k3iyer/arduino-dac/Host_Software/RXTX/Windows/i368-mingw32/README

Wed Mar  1 12:01:05 MST 2006
rxtxSerial.dll had to be recomopiled to link in missing native methods.
