k3iyer/arduino-dac/Device_Hardware/Battery Cycler - Pin assignments.xls

Battery Cycler - Pin Assignments
Arduino Digital I/O | assignment | description
0 | Serial(RX) | connected to ft232r chip
1 | Serial(TX) | connected to ft232r chip
2 | push button up |  | Note: pins 1 & 2 external interrupts
3 | push button select
4 | push button down
5 | LCD D4 / CS ADC1 | lcd data bit 4 and also the chip select for the ADC on ch1 | Note: when using the charge/load mode select we can get away with only one 2 channel DAC if we want
6 | LCD D5 / CS DAC1
7 | LCD D6 / CS DAC2
8 | LCD D7 / CS AUX
9 | LCD RS
10 | LCD enable
11 | SPI (MOSI) | master out slave in
12 | SPI (MISO) | master in slave out
13 | SPI (SCK) | serial clock
Arduino Analog inputs
0 | CH1 cell temp
1 | CH2 cell temp
2 | Chamber air temp
3 | 595 data latch | latch data into the 595 shift register, cannot share like a CS
4 | I2C SDA
5 | I2C SCL
Outputs on 74HC595
B0 / A | TRIAC control output | slow PWM the triac
B1 | Fan control output | enable / disable the load/charge bank cooling fans
B2 | Mode select CH0 | charge / discharge selector for CH0
B3 | Mode select CH1 | charge / discharge selector for CH1
B4
B5 | charge enable
B6 | panel Fault LED
B7 / H | heartbeat for watchdog
