k3iyer/arduino-dac/Documentation/Experimentation/data from level shifting design.xlsx

Batt voltage | meas ref | meas -vbat | meas sum | meas I | calc | measured sum - calc sum | error current | corrected current
2 | 0.05216 | 4.0336 | 4.087 | 2.07 | 4.08576 | 0.00124 | 0.0248 | 2.0948
2.5 | 0.05214 | 3.531 | 3.585 | 2.07 | 3.58314 | 0.00186 | 0.0372 | 2.1072
3 | 0.05214 | 3.029 | 3.083 | 2.08 | 3.08114 | 0.00186 | 0.0372 | 2.1172
3.5 | 0.05212 | 2.533 | 2.585 | 2.128 | 2.58512 | -0.00012 | -0.0024 | 2.1256
4 | 0.05211 | 2.033 | 2.086 | 2.175 | 2.08511 | 0.00089 | 0.0178 | 2.1928
4.2 | 0.05213 | 1.832 | 1.884 | 2.188 | 1.88413 | -0.00013 | -0.0026 | 2.1854
Charge Ref | Charge I |  | Discharge Ref | Discharge I
0.01 | 1.164 |  | 0.01 | 2.008
0.02 | 1.363 |  | 0.02 | 1.898
0.03 | 1.563 |  | 0.03 | 1.701
0.04 | 1.763 |  | 0.04 | 1.508
0.05 | 1.997 |  | 0.05 | 1.314
0.06 | 2.177 |  | 0.06 | 1.117
0.07 | 2.371 |  | 0.07 | 0.977
0.08 | 2.57 |  | 0.08 | 0.976
0.09 | 2.768 |  | 0.09 | 0.977
0.1 | 2.966 |  | 0.1 | 0.976
Discharge Ref | Batt current
0.01 | 2.172
0.02 | 2.343
0.03 | 2.513
0.04 | 2.674
0.05 | 2.837
0.06 | 2.99
0.07 | 3.171
0.08 | 3.326
0.09 | 3.506
0.1 | 3.672
