k3iyer/arduino-dac/Documentation/Official/archive/battery cycler menus.docx

MENU SYSTEM:

There are currently 5 different configuration menus.

E | X | I | T
| | | | | | | | | | | | | | → | →
+ | + | | | | | | | | | | | | | + | +

D | I | S | P | | T | I | M | E | | O | U | T

D | I | S | P | | D | E | L | A | Y | | T | I | M | E

F | A | N | | O | N | | T | E | M | P

S | W | | V | E | R | S | I | O | N

STATS DISPLAY:

Currently there are 8 status displays; they are shown here in they same order as on the system.

C | H | 1 | : | | A | C | T | I | V | E | | # | 2 | 5 | 6
| | | | | I | D | L | E
| | | | | F | A | U | L | T | | | # | 2 | 5 | 6
C | H | 2 | : | | A | C | T | I | V | E | | # | 2 | 5 | 6

C | H | 1/2 | : | | | | V | = | | | 6 | . | 0 | 0 | 0
W | = | +/- | 1 | 5 | 0 | | I | = | +/- | 2 | 0 | . | 0 | 0 | 0

C | H | ½ | : | | | | S | O | C | = | 1 | 0 | 0 | . | 5
| C | E | L | L | | T | E | M | P | = | 1 | 5 | 0 | ° | C

C | H | ½ | : | | | L | O | A | D | = | 1 | 5 | 0 | ° | C
| | | | C | H | A | R | G | E | = | 1 | 5 | 0 | ° | C

C | H | M | B | R | | | S | E | T | = | 1 | 5 | 0 | ° | C
| | | | | | M | E | A | S | = | 1 | 5 | 0 | ° | C
