k3iyer/arduino-dac/Documentation/Official/Graphics/1940 -  Speed Cycler Sticker.gif

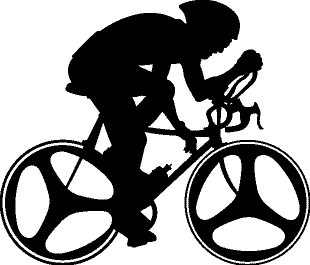
Documentation/Official/Graphics/1940 - Speed Cycler Sticker.gif
