k3iyer/arduino-dac/Documentation/Official/Graphics/LI-18650-T.400.jpg

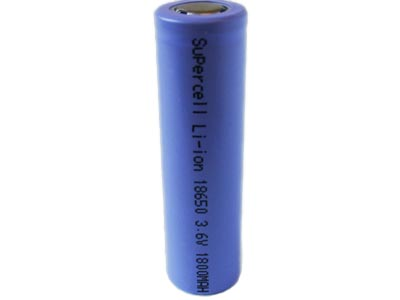
Documentation/Official/Graphics/LI-18650-T.400.jpg
