k3iyer/arduino-dac/Documentation/Official/Graphics/re-cycler.GIF

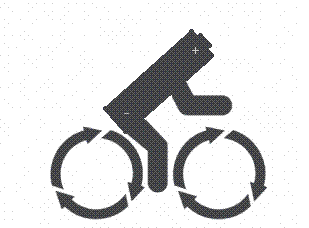
Documentation/Official/Graphics/re-cycler.GIF
