k3iyer/arduino-dac/Documentation/Official/Graphics/re-cycler.png

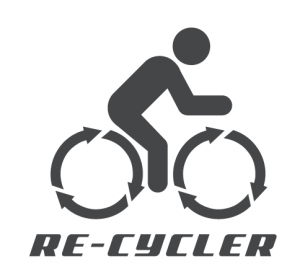
Documentation/Official/Graphics/re-cycler.png
