k3iyer/arduino-dac/Device_Hardware/bom/BOM battery tester - Initial order.xlsx

BOM For: | 2-channel Tybin board for lifecycle testing
Date: | 2010-06-25
Number of units: | 14
Item # | Description | Part Number | Retailer | Unit Cost $ | Order QTY | Extended Cost $
6 | dual DAC | MCP4822-E/SN-ND (http://search.digikey.com/scripts/DkSearch/dksus.dll?Detail&name=MCP4822-E/SN-ND) | Digikey | $3.60 | 28 | $100.80
7 | 5mOhm current shunt for data acq | 13FR005E-ND (http://search.digikey.com/scripts/DkSearch/dksus.dll?Detail&name=13FR005E-ND) | Digikey | $1.72 | 28 | $48.16
8 | IC Current Monitor, bidirectional (replaces diff amp) | AD8210WYRZ-ND (http://search.digikey.com/scripts/DkSearch/dksus.dll?Detail&name=AD8210WYRZ-ND) | Digikey | $2.78 | 140 | $389.20
12 | 12A n-channel mosfets | RFP12N10L | Digikey | $0.62 | 224 | $138.88
13 | 50mOhm current shunts for feedback | 630HR050E-ND | Digikey | $0.45 | 224 | $99.68
18 | Temp Sensor, Chamber control, Cell monitoring | LM35DZ-ND (http://search.digikey.com/scripts/DkSearch/dksus.dll?Detail&name=LM35DZ-ND) | Digikey | $1.37 | 56 | $76.72
25 | KPS55 5V 3W supply TDK-Lambda | 285-1421-ND | Digikey | $17.00 | 14 | $238.00
26 | Power supply TDK-Lambda 5V 20A SNG OUTPUT | 285-1611-ND | Digikey | $54.00 | 14 | $756.00
54 | 8A SSR | 425-2405-5-ND | Digikey | $9.40 | 14 | $131.60
55 | Varistor 140Vrms 10mm radial | 495-1429-ND | Digikey | $0.51 | 14 | $7.14
29 | Heatsinks 41.91 x 25.40 x 50.8mm for load bank | 345-1035-ND | Digikey | $1.54 | 224 | $344.96
36 | Pomona 72' Red test lead | 501-1052-ND | Digikey | $4.56 | 28 | $127.68
37 | Pomona 72' Black test lead | 501-1049-ND (http://search.digikey.com/scripts/DkSearch/dksus.dll?Detail&name=501-1049-ND) | Digikey | $4.56 | 28 | $127.68
39 | 500' spool of 3conductor 22AWG for temp sensors ($89.43 / 12)=7.45 | W121-500-ND (http://search.digikey.com/scripts/DkSearch/dksus.dll?Detail&name=W121-500-ND) | Digikey | $89.43 | 1 | $89.43
40 | 4pos 0.1" pitch female socket for connecting lm35 sensors | A28582-ND | Digikey | $0.63 | 56 | $35.28
41 | 4pos 0.1" pitch male plug for connecting lm35 sensors | A34192-ND | Digikey | $0.51 | 56 | $28.45
57 | 6A IEC 320-C14 line entry with dpst switch and fuse holder | Q306-ND (http://search.digikey.com/scripts/DkSearch/dksus.dll?Detail&name=Q306-ND) | Digikey | $6.20 | 1 | $6.20
58 | nema 5-15 receptacle for output to heater | Q337-ND | Digikey | $0.50 | 1 | $0.50
59 | IEC 320-C13 6' line cord | Q102-ND (http://search.digikey.com/scripts/DkSearch/dksus.dll?Detail&name=Q102-ND) | Digikey | $3.00 | 1 | $3.00
 | IEC 320-C14 3.25' cord (chamber air cictulator) | Q128-ND (http://search.digikey.com/scripts/DkSearch/dksus.dll?Detail&name=Q128-ND) | Digikey | $3.25 | 1 | $3.25
 | IEC 320-C13 outlet (chamber air circulator) | Q223-ND (http://search.digikey.com/scripts/DkSearch/dksus.dll?Detail&name=Q223-ND) | Digikey | $0.91 | 1 | $0.91
 | 12AWG Black test lead 100' | 602-6718-100-02 | Mouser | $165.00 | 1 | $165.00
 | 12AWG Red test lead 100' | 602-6718-100-03 | Mouser | $165.00 | 1 | $165.00
 | 120mm air circulation fan, thermal chamber | 670-OA109AP113TB (http://mouser.com/ProductDetail/Orion-Fans/OA109AP-11-3TB/) | Mouser | $14.79 | 1 | $14.79
20 | 60mm cooling fan | OD6025-05HB | Mouser | $9.18 | 2 | $18.36
46 | 3pos molex KK PCB header for fan connection | 09-65-2038 | Mouser | $0.52 | 2 | $1.04
47 | 3pos molex KK crimp connector for fan connection | 09-50-1031 | Mouser | $0.55 | 2 | $1.10
2 | Hantronix 16x2 STN LCD | HDM16216L-5-E30S | Mouser | $8.49 | 14 | $118.86
5 | 14BIT 4 channel, 200KSPS ADC | 595-TLC3544IDW | Mouser | $11.73 | 14 | $164.22
35 | dual banana binding posts red/blk | 565-6883 | Mouser | $2.80 | 56 | $156.80
1 | Arduino Duemilanove | DEV-00666 | Sparkfun | $29.95 | 14 | $419.30
30 | Bud Industries PRM-14462 Rack mount enclosure | PRM-14462 | Newark | $35.00 | 1 | $35.00
 |  |  |  |  | Total: | $4012.99
