k3iyer/arduino-dac/Device_Hardware/bom/BOM DLC board for ted.xlsx

Sheet: Sheet1
BOM For: | 2-channel DLC (data acq, load, charge) board for lifecycle testing
Date: | 2010-06-24
 | Areas where cost could possibly be reduced
 |  |  |  |  |  |  |  | Number systems being built = | 12
Item # | Description | Part Number | Reatiler | Order? | QTY | Unit Cost $ | Extended Cost $ |  | ORDER QTY | ORDER COST $
 | Electronics
1 | Arduino Duemilanove | DEV-00666 | Sparkfun | 1 | 1 | 29.95 | 29.95 |  | 12 | 359.4
2 | Hantronix 16x2 STN LCD | HDM16216H-5-S00S | Mouser | 1 | 1 | 7.43 | 7.43 |  | 12 | 89.16
3
4 | Insturmentation Amplifiers for data acq voltage | AD8221ARZ-ND | Digikey | 1 | 2 | 5.42 | 10.84 | Note: Can we get rid of these for cell voltages too? Voltage droop over trace? | 24 | 130.08
5 | 14BIT 4 channel, 200KSPS ADC | TLC3544 | Newark | 1 | 1 | 11.73 | 11.73 |  | 12 | 140.76
6 | dual DAC | MCP4822-E/P-ND | Digikey | 1 | 2 | 3.6 | 7.2 |  | 24 | 86.4
7 | 5mOhm current shunt | 13FR005E-ND (http://search.digikey.com/scripts/DkSearch/dksus.dll?Detail&name=13FR005E-ND) | Digikey | 1 | 1 | 1.72 | 1.72
8 | IC Current Monitor, bidirectional (replaces diff amp) | AD8210WYRZ-ND (http://search.digikey.com/scripts/DkSearch/dksus.dll?Detail&name=AD8210WYRZ-ND) | Digikey | 1 | 2 | 4.07 | 8.14
9 | Temp Sensor TO-220 | TC622VAT-ND | Digikey | 1 | 4 | 1.46 | 5.84 |  | 48 | 70.08
10
11
12 | 12A n-channel mosfets | RFP12N10L | Digikey | 1 | 16 | 0.89 | 14.24 |  | 192 | 170.88
13 | 50mOhm current shunts | 630HR050E-ND | Digikey | 1 | 16 | 0.445 | 7.12 |  | 192 | 85.44
14 | low noise quad opamp | MC33079PGOS-ND | Digikey | 1 | 8 | 1.44 | 11.52 |  | 96 | 138.24
15 | 10K ohm resistor packs 8ea | NOMCT16-10K-ACT-ND | Digikey |  | 8 | 5.6 | 0 |  | 96 | 0
16
17
18 | Temp Sensor, Chamber control, Cell monitoring | LM35DZ-ND (http://search.digikey.com/scripts/DkSearch/dksus.dll?Detail&name=LM35DZ-ND) | Digikey | 1 | 4 | 1.37 | 5.48 |  | 48 | 65.76
19 | Small logic level gate for switching opamps and fans | 568-3244-1-ND | Digikey | 1 | 6 | 0.54 | 3.24 |  | 72 | 38.88
20 | 60mm cooling fan | OD6025-12HS-C | Mouser | 1 | 2 | 4.95 | 9.9 |  | 24 | 118.8
21 |  |  |  |  |  |  | 0 |  | 0 | 0
22 | PCB - PCBexpress E2 (45-64^2in boards) ($680 for 15 / 12) |  | PCBExpress |  | 1 | 56.6 | 0 |  | 12 | 0
23
24 | charge pump voltage inverter for opamp nexative supply | TC962COE-ND (http://search.digikey.com/scripts/DkSearch/dksus.dll?Detail&name=TC962COE-ND) | Digikey | 1 | 1 | 3.48 | 3.48 |  | 12 | 41.76
25 | Wall xfmr 12Vdc 500ma | T983-P5P-ND | Digikey | 1 | 1 | 6.98 | 6.98 |  | 12 | 83.76
26 | Power supply TDK-Lambda 5V 20A SNG OUTPUT | 285-1611-ND | Digikey | 1 | 1 | 54 | 54 |  | 12 | 648
27 | Mechanical |  |  |  |  |  | 0 |  | 0 | 0
28 | Heatsinks 16.25 x 16.25 x 50.8mm for charger | 345-1027-ND | Digikey | 0 | 0 | 2.25 | 0 |  | 0 | 0
29 | Heatsinks 41.91 x 25.40 x 50.8mm for load bank | 345-1035-ND | Digikey | 1 | 16 | 2.2 | 35.2 |  | 192 | 422.4
30 | Bud Industries PRM-14462 Rack mount enclosure | PRM-14462 | Newark | 1 | 1 | 35 | 35 |  | 12 | 420
31
32 |  |  |  |  |  |  | 0 |  | 0 | 0
33 |  |  |  |  |  |  | 0 |  | 0 | 0
34 | misc wiring and connectors |  |  |  | 1 | 10 | 0 |  | 12 | 0
35 | dual banana binding posts red/blk | 565-6883 | Mouser | 1 | 4 | 2.8 | 11.2 |  | 48 | 134.4
36 | Pomona 72' Red test lead | 501-1052-ND | Digikey | 1 | 4 | 4.56 | 18.24 |  | 48 | 218.88
37 | Pomona 72' Black test lead | 501-1049-ND (http://search.digikey.com/scripts/DkSearch/dksus.dll?Detail&name=501-1049-ND) | Digikey | 1 | 4 | 4.56 | 18.24 |  | 48 | 218.88
38 |  |  |  |  |  |  | 0 |  | 0 | 0
39 | 500' spool of 3conductor 22AWG for temp sensors ($89.43 / 12)=7.45 | W121-500-ND (http://search.digikey.com/scripts/DkSearch/dksus.dll?Detail&name=W121-500-ND) | Digikey | 1 | 1 | 7.45 | 7.45 | Note: can cut cost in half by using ribbon cable (MB10R-100-ND) | 12 | 89.4
40 | 4pos 0.1" pitch female socket for connecting lm35 sensors | A28582-ND | Digikey | 1 | 4 | 0.63 | 2.52 |  | 48 | 30.24
41 | 4pos 0.1" pitch male plug for connecting lm35 sensors | A34192-ND | Digikey | 1 | 4 | 0.508 | 2.032 |  | 48 | 24.384
42 |  |  |  |  |  |  | 0 |  | 0 | 0
43 | 2 pos High Current connector socket for PSW and Panel connections | 42819-2222 | Mouser | 1 | 3 | 1.94 | 5.82 |  | 36 | 69.84
44 | 2 pos High Current connector plug for PSW and Panel connections | 42816-0212 | Mouser | 1 | 3 | 1.15 | 3.45 |  | 36 | 41.4
45 |  |  |  |  |  |  | 0 |  | 0 | 0
46 | 3pos molex KK PCB header for fan connection | 09-65-2038 | Mouser | 1 | 2 | 0.52 | 1.04 |  | 24 | 12.48
47 | 3pos molex KK crimp connector for fan connection | 09-50-1031 | Mouser | 1 | 2 | 0.55 | 1.1 |  | 24 | 13.2
48 |  |  |  |  |  |  | 0 |  | 0 | 0
49
50 |  |  |  |  |  |  | 0 |  | 0 | 0
51 |  |  |  |  |  |  | 0 |  | 0 | 0
52 | Thermal Chamber |  |  |  |  |  | 0 |  | 0 | 0
53 | 4' x 8' sheet of 0.5" Super TUFF-R insulation |  | Home Depot |  | 1 | 11 | 0 |  | 12 | 0
54 | 8A SSR | 425-2405-5-ND | Digikey | 1 | 1 | 9.4 | 9.4 |  | 12 | 112.8
55 | Varistor 140Vrms 10mm radial | 495-1429-ND | Digikey | 1 | 1 | 0.51 | 0.51 |  | 12 | 6.12
56 | SCR200W Crockpot | SCR200W | Walmart |  | 1 | 10 | 0 |  | 12 | 0
57 | 10A line entry with dpst switch and fuse | Q308-ND | Digikey | 1 | 1 | 8.23 | 8.23 |  | 12 | 98.76
58 | nema 5-15 receptacle for output to heater | Q337-ND | Digikey | 1 | 1 | 0.5 | 0.5 |  | 12 | 6
59 |  |  |  |  |  |  | 0 |  | 0 | 0
60 |  |  |  |  |  |  | 0 |  | 0 | 0
61 |  |  |  |  |  |  | 0 |  | 0 | 0
62 |  |  |  |  |  |  | 0 |  | 0 | 0
63 |  |  |  |  |  |  | 0 |  | 0 | 0
64 |  |  |  |  |  |  | 0 |  | 0 | 0
65 |  |  |  |  |  |  | 0 |  | 0 | 0
66 |  |  |  |  |  |  | 0 |  | 0 | 0
67 |  |  |  |  |  |  | 0 |  | 0 | 0
68 |  |  |  |  |  |  | 0 |  | 0 | 0
69 |  |  |  |  |  |  | 0 |  | 0 | 0
70 |  |  |  |  |  |  | 0 |  | 0 | 0
 |  |  |  |  |  | Total Price $ | 358.742 |  | ORDER TOTAL$ | 4186.584
 |  |  |  |  |  | Cost per channel | 179.371

Sheet: Sheet2
BOM For: | 2-channel DLC (data acq, load, charge) board for lifecycle testing
Date: | 2010-06-25
Item # | Description | Part Number | Reatiler | Unit Cost $ | Order QTY | Extended Cost $
6 | dual DAC | MCP4822-E/SN-ND (http://search.digikey.com/scripts/DkSearch/dksus.dll?Detail&name=MCP4822-E/SN-ND) | Digikey | $3.60 | 28 | $100.80
7 | 5mOhm current shunt for data acq | 13FR005E-ND (http://search.digikey.com/scripts/DkSearch/dksus.dll?Detail&name=13FR005E-ND) | Digikey | $1.72
8 | IC Current Monitor, bidirectional (replaces diff amp) | AD8210WYRZ-ND (http://search.digikey.com/scripts/DkSearch/dksus.dll?Detail&name=AD8210WYRZ-ND) | Digikey | $4.07
12 | 12A n-channel mosfets | RFP12N10L | Digikey | $0.89 | 224 | $199.36
13 | 50mOhm current shunts for feedback | 630HR050E-ND | Digikey | $0.45 | 224 | $99.68
18 | Temp Sensor, Chamber control, Cell monitoring | LM35DZ-ND (http://search.digikey.com/scripts/DkSearch/dksus.dll?Detail&name=LM35DZ-ND) | Digikey | $1.37 | 56 | $76.72
25 | KPS55 5V 3W supply TDK-Lambda | 285-1421-ND | Digikey | $17.00 | 14 | $238.00
26 | Power supply TDK-Lambda 5V 20A SNG OUTPUT | 285-1611-ND | Digikey | $54.00 | 14 | $756.00
54 | 8A SSR | 425-2405-5-ND | Digikey | $9.40 | 14 | $131.60
55 | Varistor 140Vrms 10mm radial | 495-1429-ND | Digikey | $0.51 | 14 | $7.14
29 | Heatsinks 41.91 x 25.40 x 50.8mm for load bank | 345-1035-ND | Digikey | $2.20 | 224 | $492.80
36 | Pomona 72' Red test lead | 501-1052-ND | Digikey | $4.56 | 56 | $255.36
37 | Pomona 72' Black test lead | 501-1049-ND (http://search.digikey.com/scripts/DkSearch/dksus.dll?Detail&name=501-1049-ND) | Digikey | $4.56 | 56 | $255.36
39 | 500' spool of 3conductor 22AWG for temp sensors ($89.43 / 12)=7.45 | W121-500-ND (http://search.digikey.com/scripts/DkSearch/dksus.dll?Detail&name=W121-500-ND) | Digikey | $7.45 | 14 | $104.30
40 | 4pos 0.1" pitch female socket for connecting lm35 sensors | A28582-ND | Digikey | $0.63 | 56 | $35.28
41 | 4pos 0.1" pitch male plug for connecting lm35 sensors | A34192-ND | Digikey | $0.51 | 56 | $28.45
20 | 60mm cooling fan | OD6025-05HB | Mouser | $9.18 | 2 | $18.36
46 | 3pos molex KK PCB header for fan connection | 09-65-2038 | Mouser | $0.52 | 2 | $1.04
47 | 3pos molex KK crimp connector for fan connection | 09-50-1031 | Mouser | $0.55 | 2 | $1.10
2 | Hantronix 16x2 STN LCD | HDM16216H-5-S00S | Mouser | $7.43 | 14 | $104.02
5 | 14BIT 4 channel, 200KSPS ADC | 595-TLC3544IDW | Mouser | $11.73 | 14 | $164.22
35 | dual banana binding posts red/blk | 565-6883 | Mouser | $2.80 | 56 | $156.80
1 | Arduino Duemilanove | DEV-00666 | Sparkfun | $29.95 | 14 | $419.30
30 | Bud Industries PRM-14462 Rack mount enclosure | PRM-14462 | Newark | $35.00 | 1 | $35.00
 |  |  |  |  | Total: | $3680.69
