k3iyer/arduino-dac/Device_Hardware/bom/BOM DLC board proto.xlsx

BOM For: | Proto Sample parts for - 2-channel DLC (data acq, load, charge) board for lifecycle testing
Date: | 2010-06-15
Item # | Description | Part Number | QTY | Unit Price $ | Extended Price $
1 | Small logic level gate for switching opamps (may not need if we get opamps that work close enough to there rails, can just switch with the IO pin of the micro!) | 568-3244-1-ND | 5 | 0.54 | 2.7
2 | Insturmentation Amplifiers for data acq voltage | AD8221ARZ-ND (http://search.digikey.com/scripts/DkSearch/dksus.dll?Detail&name=AD8221ARZ-ND) | 1 | 5.42 | 5.42
3 | LV charge pump voltage doubler | TC7660SEPA-ND (http://search.digikey.com/scripts/DkSearch/dksus.dll?Detail&name=TC7660SEPA-ND) | 2 | 1.6 | 3.2
4 | HV microchip charge pump DIP | TC7662ACPA-ND (http://search.digikey.com/scripts/DkSearch/dksus.dll?Detail&name=TC7662ACPA-ND) | 1 | 3.17 | 3.17
5 | Temp sensor | LM35DZ-ND (http://search.digikey.com/scripts/DkSearch/dksus.dll?Detail&name=LM35DZ-ND) | 2 | 1.71 | 3.42
6 | dual DAC | MCP4822-E/P-ND (http://search.digikey.com/scripts/DkSearch/dksus.dll?Detail&name=MCP4822-E/P-ND) | 1 | 3.6 | 3.6
7 | quad opamps for controlling mosfets(low input offset, Rail-Rail) | 296-7129-5-ND (http://search.digikey.com/scripts/DkSearch/dksus.dll?Detail&name=296-7129-5-ND) | 2 | 2.2 | 4.4
8 | low noise quad opamp | MC33079PGOS-ND (http://search.digikey.com/scripts/DkSearch/dksus.dll?Detail&name=MC33079PGOS-ND) | 4 | 1.44 | 5.76
9 | 5W 0.001 ohm current shunt | LVRC-.01RCT-ND (http://search.digikey.com/scripts/DkSearch/dksus.dll?Detail&name=LVRC-.01RCT-ND) | 1 | 1.61 | 1.61
10 | 20W 0.03 ohm current shunt | TK20PR030JE-ND (http://search.digikey.com/scripts/DkSearch/dksus.dll?Detail&name=TK20PR030JE-ND) | 1 | 4.87 | 4.87
11 |  |  |  |  | 0
12 |  |  |  |  | 0
13 |  |  |  |  | 0
14 |  |  |  |  | 0
15 |  |  |  |  | 0
16 |  |  |  |  | 0
17 |  |  |  |  | 0
18 |  |  |  |  | 0
19 |  |  |  |  | 0
20 |  |  |  |  | 0
21 |  |  |  |  | 0
22 |  |  |  |  | 0
23 |  |  |  |  | 0
24 |  |  |  |  | 0
25 |  |  |  |  | 0
26 |  |  |  |  | 0
27 |  |  |  |  | 0
28 |  |  |  |  | 0
29 |  |  |  |  | 0
30 |  |  |  |  | 0
 |  |  |  | Total Price $ | 38.15
