k3iyer/arduino-dac/Device_Hardware/bom/BOM DLC board.xlsx

Sheet: BOM
BOM For: | 2-channel DLC (data acq, load, charge) board for lifecycle testing
Date: | 2010-06-24
 | Areas where cost could possibly be reduced |  |  |  |  |  |  |  | Build units:
 |  |  |  |  |  |  |  |  | 14
Item # | Description | Part Number | Reatiler | ORDER NOW | QTY | Unit Cost $ | Extended Cost $ | Subsystem cost $ | ORDER QTY | ORDER COST $
 | Electronics |  |  |  |  |  |  | $299.14
6 | 12-Bit SPI DAC dual | MCP4822-E/SN-ND (http://search.digikey.com/scripts/DkSearch/dksus.dll?Detail&name=MCP4822-E/SN-ND) | Digikey | Y | 2 | 3.6 | 7.2 |  | 28 | 100.8
7 | 5mOhm current shunt for data acq | 13FR005E-ND (http://search.digikey.com/scripts/DkSearch/dksus.dll?Detail&name=13FR005E-ND) | Digikey | Y | 1 | 1.72 | 1.72
3 |  |  |  |  |  |  | $0.00
4 | Insturmentation Amplifiers for data acq voltage | AD8221ARZ-ND | Digikey |  | 2 | $5.42 | $10.84 |  | 28 | $151.76
 | Vrefs 4.096 | REF198FSZ-ND (http://search.digikey.com/scripts/DkSearch/dksus.dll?Detail&name=REF198FSZ-ND) | Digikey
 | 2.048
8 | IC Current Monitor, bidirectional (replaces diff amp) | AD8210WYRZ-ND (http://search.digikey.com/scripts/DkSearch/dksus.dll?Detail&name=AD8210WYRZ-ND) | Digikey | Y | 10 | 2.78 | 27.8
12 | 12A n-channel mosfets | RFP12N10L | Digikey | Y | 16 | 0.89 | 14.24 |  | 224 | 199.36
13 | 50mOhm current shunts for feedback | 630HR050E-ND | Digikey | Y | 16 | 0.445 | 7.12 |  | 224 | 99.68
18 | Temp Sensor, Chamber control, Cell monitoring | LM35DZ-ND (http://search.digikey.com/scripts/DkSearch/dksus.dll?Detail&name=LM35DZ-ND) | Digikey | Y | 4 | 1.37 | 5.48 |  | 56 | 76.72
9 | Temp Sensor TO-220 | TC622VAT-ND | Digikey |  | 4 | $1.46 | $5.84 |  | 56 | $81.76
10 |  |  |  |  |  |  | $0.00
11 |  |  |  |  |  |  | $0.00
25 | KPS55 5V 3W supply TDK-Lambda | 285-1421-ND | Digikey | Y | 1 | 17 | 17 |  | 14 | 238
26 | Power supply TDK-Lambda 5V 20A SNG OUTPUT | 285-1611-ND | Digikey | Y | 1 | 54 | 54 |  | 14 | 756
14 | low noise quad opamp | MC33079PGOS-ND | Digikey |  | 8 | $1.44 | $11.52 |  | 112 | $161.28
15 | 10K ohm resistor packs 8ea | NOMCT16-10K-ACT-ND | Digikey |  | 4 | $5.60 | $22.40 |  | 56 | $313.60
16 |  |  |  |  |  |  | $0.00
17 |  |  |  |  |  |  | $0.00
54 | 8A SSR | 425-2405-5-ND | Digikey | Y | 1 | 9.4 | 9.4 |  | 14 | 131.6
19 | Small logic level gate for switching opamps and fans | 568-3244-1-ND | Digikey |  | 6 | $0.54 | $3.24 |  | 84 | $45.36
20 | 60mm cooling fan | OD6025-05HB | Mouser |  | 2 | $9.18 | $18.36 |  | 28 | $257.04
21 |  |  |  |  |  |  | $0.00 |  | 0 | $0.00
22 | PCB - PCBexpress E2 (45-64^2in boards) ($680 for 15 / 12) |  | PCBExpress |  | 1 | $56.60 | $56.60 |  | 14 | $792.40
23 |  |  |  |  |  |  | $0.00
24 | charge pump voltage inverter for opamp nexative supply | TC1121COA-ND (http://search.digikey.com/scripts/DkSearch/dksus.dll?Detail&name=TC1121COA-ND) | Digikey |  | 1 | $1.23 | $1.23 |  | 14 | $17.22
55 | Varistor 140Vrms 10mm radial | 495-1429-ND | Digikey | Y | 1 | 0.51 | 0.51 |  | 14 | 7.14
29 | Heatsinks 41.91 x 25.40 x 50.8mm for load bank | 345-1035-ND | Digikey | Y | 16 | 1.54 | 24.64 |  | 224 | 344.96
57 | 6A IEC 320-C14 line entry with dpst switch and fuse holder | Q306-ND (http://search.digikey.com/scripts/DkSearch/dksus.dll?Detail&name=Q306-ND) | Digikey |  | 1 | $6.20 | $6.20 |  | 14 | $86.80
58 | nema 5-15 receptacle for output to heater | Q337-ND | Digikey |  | 1 | $0.50 | $0.50 |  | 14 | $7.00
59 | IEC 320-C13 6' line cord | Q102-ND (http://search.digikey.com/scripts/DkSearch/dksus.dll?Detail&name=Q102-ND) | Digikey |  | 1 | $3.00 | $3.00 |  | 14 | $42.00
36 | Pomona 72' Red test lead | 501-1052-ND | Digikey | Y | 4 | 4.56 | 18.24 |  | 56 | 255.36
37 | Pomona 72' Black test lead | 501-1049-ND (http://search.digikey.com/scripts/DkSearch/dksus.dll?Detail&name=501-1049-ND) | Digikey | Y | 4 | 4.56 | 18.24 |  | 56 | 255.36
27 | Mechanical |  |  |  |  |  | $0.00 | $42.45 | 0 | $0.00
28 | Heatsinks 16.25 x 16.25 x 50.8mm for charger | 345-1027-ND | Digikey |  | 0 | $2.25 | $0.00 |  | 0 | $0.00
39 | 500' spool of 3conductor 22AWG for temp sensors ($89.43 / 12)=7.45 | W121-500-ND (http://search.digikey.com/scripts/DkSearch/dksus.dll?Detail&name=W121-500-ND) | Digikey | Y | 1 | 7.45 | 7.45 |  | 14 | 104.3
30 | Bud Industries PRM-14462 Rack mount enclosure | PRM-14462 | Newark |  | 1 | $35.00 | $35.00 |  | 14 | $490.00
31 |  |  |  |  |  |  | $0.00
32 |  |  |  |  |  |  | $0.00 |  | 0 | $0.00
33 |  |  |  |  |  |  | $0.00 |  | 0 | $0.00
34 | misc wiring and connectors |  |  |  | 1 | $10.00 | $10.00 | $76.27 | 14 | $140.00
40 | 4pos 0.1" pitch female socket for connecting lm35 sensors | A28582-ND | Digikey | Y | 4 | 0.63 | 2.52 |  | 56 | 35.28
41 | 4pos 0.1" pitch male plug for connecting lm35 sensors | A34192-ND | Digikey | Y | 4 | 0.508 | 2.032 |  | 56 | 28.448
2 | Hantronix 16x2 STN LCD | HDM16216H-5-S00S | Mouser | Y | 1 | 7.43 | 7.43 |  | 14 | 104.02
38 |  |  |  |  |  |  | $0.00 |  | 0 | $0.00
5 | 14BIT 4 channel, 200KSPS ADC | HDM16216L-5-E30S | Mouser | Y | 1 | 11.73 | 11.73 |  | 14 | 164.22
35 | dual banana binding posts red/blk | 565-6883 | Mouser | Y | 4 | 2.8 | 11.2 |  | 56 | 156.8
1 | Arduino Duemilanove | DEV-00666 | Sparkfun | Y | 1 | 29.95 | 29.95 |  | 14 | 419.3
42 |  |  |  |  |  |  | $0.00 |  | 0 | $0.00
43 | 2 pos High Current connector socket for PSW and Panel connections | 42819-2222 | Mouser |  | 3 | $1.94 | $5.82 |  | 42 | $81.48
44 | 2 pos High Current connector plug for PSW and Panel connections | 42816-0212 | Mouser |  | 3 | $1.15 | $3.45 |  | 42 | $48.30
45 |  |  |  |  |  |  | $0.00 |  | 0 | $0.00
46 | 3pos molex KK PCB header for fan connection | 09-65-2038 | Mouser |  | 2 | $0.52 | $1.04 |  | 28 | $14.56
47 | 3pos molex KK crimp connector for fan connection | 09-50-1031 | Mouser |  | 2 | $0.55 | $1.10 |  | 28 | $15.40
48 |  |  |  |  |  |  | $0.00 |  | 0 | $0.00
49 |  |  |  |  |  |  | $0.00
50 |  |  |  |  |  |  | $0.00 |  | 0 | $0.00
51 |  |  |  |  |  |  | $0.00 |  | 0 | $0.00
52 | Thermal Chamber |  |  |  |  |  | $0.00 | $21.00 | 0 | $0.00
53 | 4' x 8' sheet of 0.5" Super TUFF-R insulation |  | Home Depot |  | 1 | $11.00 | $11.00 |  | 14 | $154.00
56 | SCR200W Crockpot | SCR200W | Walmart |  | 1 | $10.00 | $10.00 |  | 14 | $140.00
60 |  |  |  |  |  |  | $0.00 |  | 0 | $0.00
61 |  |  |  |  |  |  | $0.00 |  | 0 | $0.00
62 |  |  |  |  |  |  | $0.00 |  | 0 | $0.00
63 |  |  |  |  |  |  | $0.00 |  | 0 | $0.00
64 |  |  |  |  |  |  | $0.00 |  | 0 | $0.00
65 |  |  |  |  |  |  | $0.00 |  | 0 | $0.00
66 |  |  |  |  |  |  | $0.00 |  | 0 | $0.00
67 |  |  |  |  |  |  | $0.00 |  | 0 | $0.00
68 |  |  |  |  |  |  | $0.00 |  | 0 | $0.00
69 |  |  |  |  |  |  | $0.00 |  | 0 | $0.00
70 |  |  |  |  |  |  | $0.00 |  | 0 | $0.00
 |  |  |  |  |  | Total Price $ | 495.042 |  | ORDER TOTAL$ | 6517.308
 |  |  |  |  |  | Cost per channel | 247.521

Sheet: Ted Inital Order
BOM For: | 2-channel DLC (data acq, load, charge) board for lifecycle testing
Date: | 2010-06-25
Number of units: | 14
Item # | Description | Part Number | Retailer | Unit Cost $ | Order QTY | Extended Cost $
6 | dual DAC | MCP4822-E/SN-ND (http://search.digikey.com/scripts/DkSearch/dksus.dll?Detail&name=MCP4822-E/SN-ND) | Digikey | $3.60 | 28 | $100.80
7 | 5mOhm current shunt for data acq | 13FR005E-ND (http://search.digikey.com/scripts/DkSearch/dksus.dll?Detail&name=13FR005E-ND) | Digikey | $1.72 | 28 | $48.16
8 | IC Current Monitor, bidirectional (replaces diff amp) | AD8210WYRZ-ND (http://search.digikey.com/scripts/DkSearch/dksus.dll?Detail&name=AD8210WYRZ-ND) | Digikey | $2.78 | 140 | $389.20
12 | 12A n-channel mosfets | RFP12N10L | Digikey | $0.62 | 224 | $138.88
13 | 50mOhm current shunts for feedback | 630HR050E-ND | Digikey | $0.45 | 224 | $99.68
18 | Temp Sensor, Chamber control, Cell monitoring | LM35DZ-ND (http://search.digikey.com/scripts/DkSearch/dksus.dll?Detail&name=LM35DZ-ND) | Digikey | $1.37 | 56 | $76.72
25 | KPS55 5V 3W supply TDK-Lambda | 285-1421-ND | Digikey | $17.00 | 14 | $238.00
26 | Power supply TDK-Lambda 5V 20A SNG OUTPUT | 285-1611-ND | Digikey | $54.00 | 14 | $756.00
54 | 8A SSR | 425-2405-5-ND | Digikey | $9.40 | 14 | $131.60
55 | Varistor 140Vrms 10mm radial | 495-1429-ND | Digikey | $0.51 | 14 | $7.14
29 | Heatsinks 41.91 x 25.40 x 50.8mm for load bank | 345-1035-ND | Digikey | $1.54 | 224 | $344.96
36 | Pomona 72' Red test lead | 501-1052-ND | Digikey | $4.56 | 28 | $127.68
37 | Pomona 72' Black test lead | 501-1049-ND (http://search.digikey.com/scripts/DkSearch/dksus.dll?Detail&name=501-1049-ND) | Digikey | $4.56 | 28 | $127.68
39 | 500' spool of 3conductor 22AWG for temp sensors ($89.43 / 12)=7.45 | W121-500-ND (http://search.digikey.com/scripts/DkSearch/dksus.dll?Detail&name=W121-500-ND) | Digikey | $89.43 | 1 | $89.43
40 | 4pos 0.1" pitch female socket for connecting lm35 sensors | A28582-ND | Digikey | $0.63 | 56 | $35.28
41 | 4pos 0.1" pitch male plug for connecting lm35 sensors | A34192-ND | Digikey | $0.51 | 56 | $28.45
57 | 6A IEC 320-C14 line entry with dpst switch and fuse holder | Q306-ND (http://search.digikey.com/scripts/DkSearch/dksus.dll?Detail&name=Q306-ND) | Digikey | $6.20 | 1 | $6.20
58 | nema 5-15 receptacle for output to heater | Q337-ND | Digikey | $0.50 | 1 | $0.50
59 | IEC 320-C13 6' line cord | Q102-ND (http://search.digikey.com/scripts/DkSearch/dksus.dll?Detail&name=Q102-ND) | Digikey | $3.00 | 1 | $3.00
 | IEC 320-C14 3.25' cord (chamber air cictulator) | Q128-ND (http://search.digikey.com/scripts/DkSearch/dksus.dll?Detail&name=Q128-ND) | Digikey | $3.25 | 1 | $3.25
 | IEC 320-C13 outlet (chamber air circulator) | Q223-ND (http://search.digikey.com/scripts/DkSearch/dksus.dll?Detail&name=Q223-ND) | Digikey | $0.91 | 1 | $0.91
 | 12AWG Black test lead 100' | 602-6718-100-02 | Mouser | $165.00 | 1 | $165.00
 | 12AWG Red test lead 100' | 602-6718-100-03 | Mouser | $165.00 | 1 | $165.00
 | 120mm air circulation fan, thermal chamber | 670-OA109AP113TB (http://mouser.com/ProductDetail/Orion-Fans/OA109AP-11-3TB/) | Mouser | $14.79 | 1 | $14.79
20 | 60mm cooling fan | OD6025-05HB | Mouser | $9.18 | 2 | $18.36
46 | 3pos molex KK PCB header for fan connection | 09-65-2038 | Mouser | $0.52 | 2 | $1.04
47 | 3pos molex KK crimp connector for fan connection | 09-50-1031 | Mouser | $0.55 | 2 | $1.10
2 | Hantronix 16x2 STN LCD | HDM16216L-5-E30S | Mouser | $8.49 | 14 | $118.86
5 | 14BIT 4 channel, 200KSPS ADC | 595-TLC3544IDW | Mouser | $11.73 | 14 | $164.22
35 | dual banana binding posts red/blk | 565-6883 | Mouser | $2.80 | 56 | $156.80
1 | Arduino Duemilanove | DEV-00666 | Sparkfun | $29.95 | 14 | $419.30
30 | Bud Industries PRM-14462 Rack mount enclosure | PRM-14462 | Newark | $35.00 | 1 | $35.00
 |  |  |  |  | Total: | $4012.99

Sheet: Short term proto order
BOM For: | Prototyping parts from digikey
Date: | 2010-06-28
Item # | Description | Part Number | Package | Reatiler |  | QTY | Unit Cost $ | Extended Cost $
4 | Insturmentation Amplifiers for data acq voltage | AD8221ARZ-ND |  | Digikey |  | 0 | $5.42 | $0.00
 | Vref, 4.096V +/- 5mV 10ppm/degC 30ma 8soic | REF198FSZ-ND (http://search.digikey.com/scripts/DkSearch/dksus.dll?Detail&name=REF198FSZ-ND) | 8-SOIC (3.9mm Width) | Digikey | yes | 1 | $3.83 | $3.83
 | Vref, 2.048V +/- 2mV 30ppm/degC 20ma sot23-5 | LM4132BMF-2.0CT-ND (http://search.digikey.com/scripts/DkSearch/dksus.dll?Detail&name=LM4132BMF-2.0CT-ND) | SOT-23-5, SC-74A, SOT-25 | Digikey | yes | 1 | $3.42 | $3.42
9 | Temp Sensor TO-220 | TC622VAT-ND |  | Digikey | yes | 1 | $1.46 | $1.46
10 | TO-92 temp sensor, can epoxy to heatsink… voltage output, so will need comparators | TMP35GT9Z-ND (http://search.digikey.com/scripts/DkSearch/dksus.dll?Detail&name=TMP35GT9Z-ND) |  | Digikey | yes | 1 | $1.35 | $1.35
 | serial TC74 to-220 I2C temp sensor | TC74A0-5.0VAT-ND |  | Digikey | yes | 1 | $1.64 | $1.64
 | IC Current monitor | AD8210YRZ-ND (http://search.digikey.com/scripts/DkSearch/dksus.dll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) | 8-SOIC (3.9mm Width) | Digikey | yes | 1 | $4.07 | $4.07
11 |  |  |  |  |  |  |  | $0.00
14 | low noise quad opamp | MC33079PGOS-ND | 14-DIP | Digikey | yes | 2 | $1.44 | $2.88
15 | 10K ohm resistor packs 8ea | NOMCT16-10K-ACT-ND |  | Digikey |  | 0 | $5.60 | $0.00
19 | Small logic level gate for switching opamps and fans | 568-3244-1-ND | SC-70-3, SOT-323-3 | Digikey | yes | 6 | $0.54 | $3.24
24 | charge pump voltage inverter for opamp nexative supply | TC1121COA-ND (http://search.digikey.com/scripts/DkSearch/dksus.dll?Detail&name=TC1121COA-ND) | 8-SOIC (3.9mm Width) | Digikey | yes | 2 | $1.23 | $2.46
 |  |  |  |  |  |  |  | $0.00
 |  |  |  |  |  |  |  | $0.00
 | MAX9913 1.8-5.5V supply 200kHz dual with shutdown | MAX9913EUB+-ND | 10-MSOP, Micro10™, 10-uMAX, 10-uSOP | Digikey | yes | 1 | $1.43 | $1.43
 | MAX4168 2.7-6.5V supply 5MHz, dual very low ioV | MAX4168ESD+-ND | 14-SOIC (3.9mm Width), 14-SOL | Digikey | yes | 1 | $3.21 | $3.21
 | MAX4230 reasonable TYP ioV of 0.85, +-6max 10MHz, dual shutdown, 2.7-5.5V | MAX4232AKA+TCT-ND (http://search.digikey.com/scripts/DkSearch/dksus.dll?Detail&name=MAX4232AKA%2BTCT-ND) | SOT-23-8 | Digikey | yes | 1 | $1.80 | $1.80
 | MAX4494 good gen purpose, 4.5-11V ok ioV dual | MAX4494ASA+-ND (http://search.digikey.com/scripts/DkSearch/dksus.dll?Detail&name=MAX4494ASA%2B-ND) | 8-SOIC (3.9mm Width) | Digikey | yes | 1 | $2.25 | $2.25
 | MCP609 gen purpose, low ioV, cheep, 7V supply max, 155kHz, quad | MCP609-I/SL-ND (http://search.digikey.com/scripts/DkSearch/dksus.dll?Detail&name=MCP609-I/SL-ND) | 14-SOIC (3.9mm Width), 14-SOL | Digikey | yes | 1 | $1.58 | $1.58
 |  |  |  |  |  |  |  | $0.00
 | Open collector watchdog, 100ms Twd | MAX6369KA+TCT-ND (http://search.digikey.com/scripts/DkSearch/dksus.dll?Detail&name=MAX6369KA%2BTCT-ND) | SOT-23-8 | Digikey | yes | 1 | $2.33 | $2.33
 | push pull watchdog, 1ms Twd | MAX6370KA+TCT-ND (http://search.digikey.com/scripts/DkSearch/dksus.dll?Detail&name=MAX6370KA%2BTCT-ND) | SOT-23-8 | Digikey | yes | 1 | $2.33 | $2.33
 |  |  |  |  |  |  |  | $0.00
 |  |  |  |  |  |  |  | $0.00
 |  |  |  |  |  |  |  | $0.00
 |  |  |  |  |  |  |  | $0.00
 | universial fairchild shift register 8bits | MM74HC589M | 16-SOIC (3.9mm Width) | Digikey | yes | 1 | 0.83 | $0.83
 | parallel to serial | 568-2626-5-ND (http://search.digikey.com/scripts/DkSearch/dksus.dll?Detail&name=568-2626-5-ND) | 16-DIP | Digikey | yes | 1 | 0.61 | $0.61
 | the 595 | MM74HC595N-ND (http://search.digikey.com/scripts/DkSearch/dksus.dll?Detail&name=MM74HC595N-ND) | 16-DIP | Digikey | yes | 1 | 0.66 | $0.66
 |  |  |  |  |  |  |  | $0.00
 |  |  |  |  |  |  |  | $0.00
 |  |  |  |  |  |  |  | $0.00
 |  |  |  |  |  |  | Total: | $41.38
Free samples from TI:
 |  | THS4281 | 8SOIC |  | Free Samples Ordered
 |  | OPA830 | 8SOIC |  | Free Samples Ordered
 |  | OPA4830 | 14-TSSOP |  | Free Samples Ordered
 | ADC | TLC3544IDW | 20SOIC, 20TSSOP |  | Free Samples Ordered
 | Quad differential comparator | LM2901 | 14-SOIC (3.9mm Width), 14-SOL |  | Free Samples Ordered
 | Still need to order lots of mech parts:
 | fuses for connection to power supply, battery terminals (current and vsense), ac mains
 | Inverter IC's
 | push buttons for front panel control
 | relays for switching battery connections
 | headers for arduino and lcd
 | spade connectors for wiring to board
 | pcb standoffs and mounting hardware
 | alum plate for mounting fans and power supply?
