k3iyer/arduino-dac/Device_Hardware/bom/Parts_Inventory.xlsx

Battery Research Lab - Electronic Components Inventory
Location | Name | Description | Digikey PN | Unit Price | Quantity in Stock | Reorder Level | Reorder Time in Days | Quantity in Reorder | Discontinued?
 | IRLZ24PBF | Mosfet N-CH 60V 17A TO0220AB | IRLZ24PBF |  | 2
 | RFP12N10L | MOSFET N-Channel 12A 100V 60W | RFP12N10L | $0.89 | 12
 | Heatsinks | 2" TO-220 Heatsinks | 345-1035-ND | $2.64 | 4
 | Wall XFMR | 12V DC 500mA | T983-P5P-ND | $6.98 | 2
 | Zener Diode | 9.1V 500mW DO-35 | 1N5239BFSCT-ND |  | 12
 | Distance Sensor | 5cm digital | 425-2615-5-ND |  | 2
 | TVS | 24W 6.5V undir sot23-2 | MMBZ10VAL-FDICT-ND |  | 3
 | MOSFET | N-Channel 60V 50A TO-220AB | RFP50N06-ND | $1.51 | 2
 | MOSFET | N-Channel 60V 12A TO-220 | MTP3055VLFS-ND |  | 4
 | OPAMP | Quad low power 12DIP | LM324NGOS-ND |  | 10
 | TRIAC | Phototriac ZC 600V 5ma 6dip | VO3063 |  | 5
 | TRIAC | 600V 10A TO-220AB | 497-3120-5-ND |  | 6
 | DIODE | SGL Junc 100V 4.0ns do-35 | 1N4148FS-ND |  | 10
 | TRIAC | triac driver zero crossing 6-dip | FOD4116-ND |  | 6
 | Eval Board | TI wireless eval board | 296-23125-ND |  | 1
 | Battery | Lithium coin batt 3V 23mm 50ma | P085-ND |  | 4
 | Cap | 100uF 10V electrolytic radial | 493-1491-ND |  | 10
 | Cap | Film MMKP 0.022 uF 1000Vdc | BC1901-ND |  | 5
 | Header | 6pos 0.050" picth | S9016E-06-ND |  | 6
 | Power Module | 600V 16A SIP2 | IRAMX16UP60B-ND |  | 1
 | Power Module | 3PH 2A 500V SIP-s | IRAM336-025SB-ND |  | 1
 | Zener Diode | 3.3V 370mw do-34 | MAZ40330MFCT-ND |  | 10
 | Header | 18PS 0.1" pitch | S7077-ND |  | 6
 | Zener Diode | 1W 3.3V do-41 | 1N4728AFSCT-ND |  | 10
 | Header | 4pos 0.050" pitch | S9016E-04-ND |  | 6
 | Varistor | 140Vrms 10mm radial | 495-1429-ND |  | 10
 | Header | 72pos two row 0.1" pitch | S2032E-36-ND |  | 5
 | Resistor | 25W 3Kohm |  |  | 1
 | Header | 0.050" pitch 6pos | S9010E-06-ND |  | 6
 | Zener Diode | 500mW 3.6V do-35 | 1N5227B-TPCT-ND |  | 10
 | Eval Board | Eval Target board | 296-23007-ND |  | 2
