k3iyer/arduino-dac/Documentation/Official/BOM battery tester - Support equipment.xlsx

BOM For: | Support equipment for battery cycler systems
Date: | 2010-08-24
Item # | Description | Part Number | Retailer | Unit Cost $ | Order QTY | Extended Cost $
1 | Battery Backup APC Smart-UPS 1500VA USB & Serial RM 2U 120V | SUA1500RM2U (http://www.cdwg.com/shop/products/default.aspx?edc=468489&enkwrd=ALLPROD%3a%28SUA1500RM2U%C2%A0%C2%A0%29) | CDWG | $651.36 | 2 | $1302.72
2 | D-Link DUB-H7 Hi-Speed USB 2.0 7 port Hub | DUB-H7 (http://www.cdwg.com/shop/products/default.aspx?edc=474344&enkwrd=ALLPROD%3a%28DUB-H7%29) | CDWG | $39.89 | 2 | $79.78
3 | Tripp Lite 6ft USB Cable AB | U022-006 (http://www.cdwg.com/shop/products/default.aspx?edc=411421&enkwrd=ALLPROD%3a%28U022-006%29) | CDWG | $3.98 | 14 | $55.72
4 | Host PC Rack Cabinet Shelf | 322126 (http://www.cdwg.com/shop/products/default.aspx?edc=322126&enkwrd=ALLPROD%3a%28322126%29) | CDWG | $46.87 | 2 | $93.74
5 | Tripp Lite 4-Post Open Frame Rack Cabinet 45U | SR4POST (http://www.cdwg.com/shop/products/default.aspx?EDC=978623) | CDWG | $329.17 | 0 | $0.00
6 | 42U Dell 19" Rack cabinet with mesh doors. | ebay (http://stores.ebay.com/bruincomputer__W0QQ_sidZ7032642?_nkw=rack&submit=Search) | Bruin Computer | $125.00 | 2 | $250.00
7 | Tripp Lite 50 Pack Square Hole Cage hardware | 1539264 (http://www.cdwg.com/shop/products/default.aspx?edc=1539264&enkwrd=ALLPROD%3a%281539264%29) | CDWG | $29.92 | 2 | $59.84
8 |  |  |  |  | 0 | $0.00
9 |  |  |  |  | 0 | $0.00
 |  |  |  |  | Total: | $1841.80
