k3iyer/arduino-dac/Documentation/Official/UPS load.xlsx

Sheet: Sheet1
UPS Sizing
Single System (2 ch) avg power consumption
Load | Avg Power (W) | Qty of loads | Total power from load (W) | Load power factor | Total power from load (VA)
Heater | 20 | 1 | 20 | 0.98 | 20.40816327
Fan | 10 | 2 | 20 | 0.8 | 25
Batt Charge | 30 | 2 | 60 | 0.98 | 61.2244898
5V PSU | 10 | 1 | 10 | 0.56 | 17.85714286
 |  | Total Load (W) | 110 | Total Load (VA) | 124.4897959
Total System Load
Battery Cycler Units(2 ch) | 110 | 6 | 660 |  | 746.9387755
usb hub | 10 | 1 | 10 | 0.5 | 20
DAQ computer | 300 | 1 | 150 | 0.8 | 187.5
 |  | Toal Load(W) | 820 | Total Load (VA) | 954.4387755

Sheet: Sheet2
UPS COSTS
Non-Rack mount
Unit cost | Rated load (W) | Cost per watt | run time (min) | energy (Wh) | Cost per Wh | unit
139.64 | 540 | $0.26 | 5 | 45 | 3.103111111 | APC RS 800VA
281.29 | 600 | $0.47 | 7.4 | 74 | 3.801216216 | APC SC1000VA
346.12 | 865 | $0.40 | 7.6 | 109.5666667 | 3.15898996 | APC SC1500VA
508.72 | 980 | $0.52 | 6.7 | 109.4333333 | 4.648674992 | APC smart UPS 1500 usb
Rack mount
unit cost | rated load | cost / watt | run time | energy (Wh) | cost per Wh | unit
171.56 | 280 | $0.61 | 5.9 | 27.53333333 | 6.230992736 | SC 450VA
408.97 | 480 | $0.85 | 5.5 | 44 | 9.294772727 | APC Spart UPS 750VA
514.99 | 800 | $0.64 | 8.1 | 108 | 4.768425926 | APC Smart-UPS x 1000
651.36 | 980 | $0.66 | 7.4 | 120.8666667 | 5.389078875 | APC Smart-UPS 1500VA
1050.36 | 1980 | $0.53 | 5.2 | 171.6 | 6.120979021 | APC Smart-UPS 2200VA
