k3iyer/arduino-dac/Documentation/Official/variables for battery cycler.xlsx

Variable Name | Size | Description
cmd_temp | 8 | the commanded chamber temperature in DegC (range 0-256)
temp | 16 | the current chamber temperature in 0.1 DegC (range 0-2560)
ch1_temp | 16 | the current ch1 cell temperature in 0.1 DegC (range 0-2560)
ch2_temp | 16 | the current ch2 cell temperature in 0.1 DegC (range 0-2560)
ch1_mode | 8 | selects the current mode of operation for this channel, this defines what process runs via a case structure, also defines the systems outputs)
ch2_mode | 8 | selects the current mode of operation for this channel, this defines what process runs via a case structure, also defines the systems outputs)
ch1_cmd_value | 16
ch2_cmd_value | 16
ch1_current | 16 | stores the measured current of the channel from the 14bit ADC.
ch2_current | 16 | stores the measured current of the channel from the 14bit ADC.
ch1_voltage | 16 | stores the measured voltage of the channel from the 14bit ADC.
ch2_voltage | 16 | stores the measured voltage of the channel from the 14bit ADC.
ch1_power | 16 | stores the current power of the channel calculated as the product of the current voltage and power
ch2_power | 16 | stores the current power of the channel calculated as the product of the current voltage and power
List of Modes
