k3iyer/arduino-dac/Documentation/Experimentation/test wire sizing.xlsx

Wiring voltage drop
Initial Headroom (V): | 0.55
Wire Awg | R/ft | total run length (ft) | total (R ) | drop at 12A (V) | Remaining headroom (V)
16 | 0.004016 | 6 | 0.024096 | 0.289 | 0.261
16 | 0.004016 | 12 | 0.048192 | 0.578 | -0.028
14 | 0.002525 | 6 | 0.01515 | 0.182 | 0.368
14 | 0.002525 | 12 | 0.0303 | 0.364 | 0.186
12 | 0.001588 | 6 | 0.009528 | 0.114 | 0.436
12 | 0.001588 | 12 | 0.019056 | 0.229 | 0.321
