k3iyer/arduino-dac/Documentation/Experimentation/SCR200W-Temp Sweep.xlsx

Time | Temp
1 | 19
2 | 18
3 | 19
4 | 19
5 | 19
6 | 19
7 | 19
8 | 19
9 | 20
10 | 20
11 | 19
12 | 19
13 | 19
14 | 19
15 | 19
16 | 19
17 | 19
18 | 19
19 | 19
20 | 19
21 | 19
22 | 19
23 | 19
24 | 19
25 | 19
26 | 19
27 | 19
28 | 19
29 | 19
30 | 18
31 | 19
32 | 19
33 | 19
34 | 19
35 | 19
36 | 19
37 | 19
38 | 19
39 | 19
40 | 19
41 | 19
42 | 19
43 | 19
44 | 19
45 | 19
46 | 19
47 | 19
48 | 19
49 | 19
50 | 19
51 | 19
52 | 19
53 | 19
54 | 19
55 | 19
56 | 19
57 | 19
58 | 19
59 | 19
60 | 19
61 | 19
62 | 19
63 | 19
64 | 19
65 | 19
66 | 19
67 | 19
68 | 19
69 | 19
70 | 19
71 | 19
72 | 19
73 | 19
74 | 19
75 | 19
76 | 19
77 | 19
78 | 19
79 | 19
80 | 19
81 | 19
82 | 19
83 | 19
84 | 19
85 | 19
86 | 19
87 | 20
88 | 19
89 | 19
90 | 19
91 | 19
92 | 19
93 | 19
94 | 19
95 | 19
96 | 20
97 | 19
98 | 19
99 | 19
100 | 19
101 | 19
102 | 19
103 | 19
104 | 19
105 | 19
106 | 19
107 | 19
108 | 19
109 | 19
110 | 19
111 | 19
112 | 19
113 | 19
114 | 19
115 | 19
116 | 19
117 | 19
118 | 20
119 | 19
120 | 19
121 | 19
122 | 19
123 | 19
124 | 19
125 | 19
126 | 19
127 | 19
128 | 19
129 | 19
130 | 19
131 | 19
132 | 19
133 | 19
134 | 20
135 | 19
136 | 19
137 | 19
138 | 19
139 | 19
140 | 19
141 | 19
142 | 19
143 | 19
144 | 19
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
