k3iyer/arduino-dac/Host_Software/DecaTest_v2/data/sched/test_sched.csv

Table_5_CD | 60
HPCC | 1
HF_IR | 1
Table_5_CD | 60
HPCC | 1
HF_IR | 1
Table_5_CD | 60
HPCC | 1
HF_IR | 1
