k3iyer/arduino-dac/Documentation/Experimentation/load bank/1.405V ref 1.63A current N-channel mosfet with 10ohm res.png

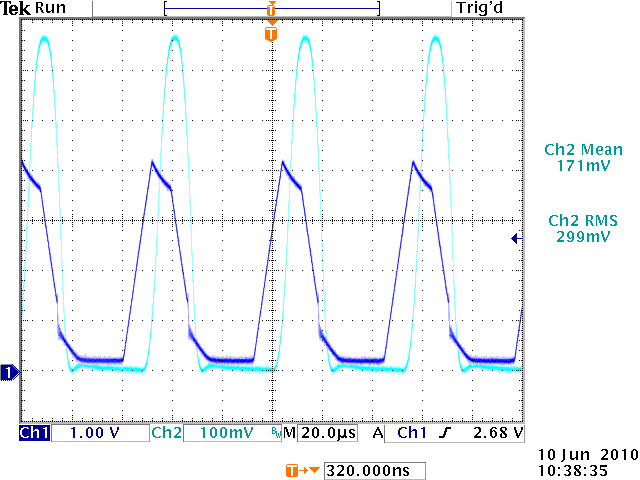
Documentation/Experimentation/load bank/1.405V ref 1.63A current N-channel mosfet with 10ohm res.png
