k3iyer/arduino-dac/Documentation/Experimentation/load bank/2V 1_99A NPN.png

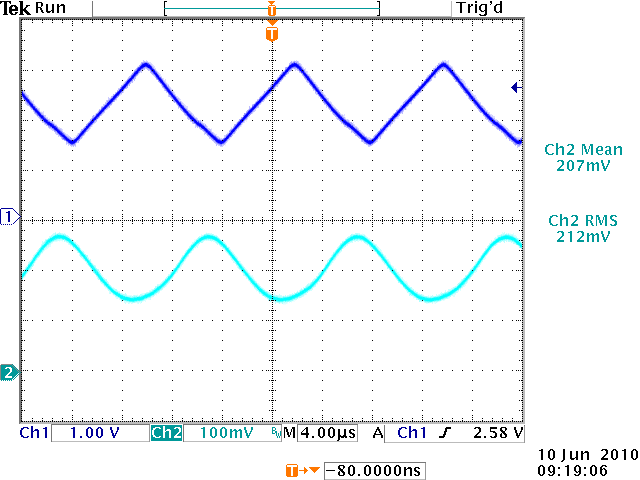
Documentation/Experimentation/load bank/2V 1_99A NPN.png
