k3iyer/arduino-dac/Documentation/Experimentation/load bank/3_5V ref 3_9A current N-channel mosfet.png

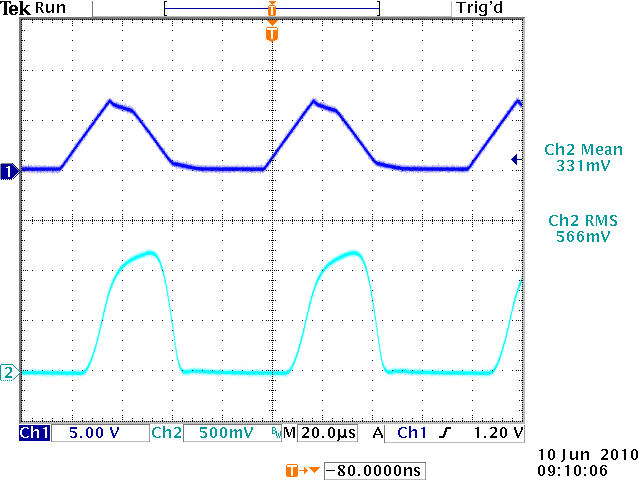
Documentation/Experimentation/load bank/3_5V ref 3_9A current N-channel mosfet.png
