k3iyer/arduino-dac/Documentation/Experimentation/load bank/5V 3_63A NPN.png

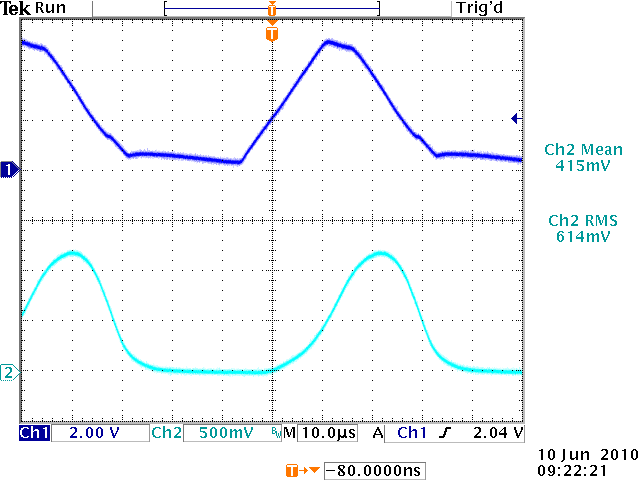
Documentation/Experimentation/load bank/5V 3_63A NPN.png
