k3iyer/arduino-dac/Documentation/Experimentation/load bank/10mV 7ma NPN.png

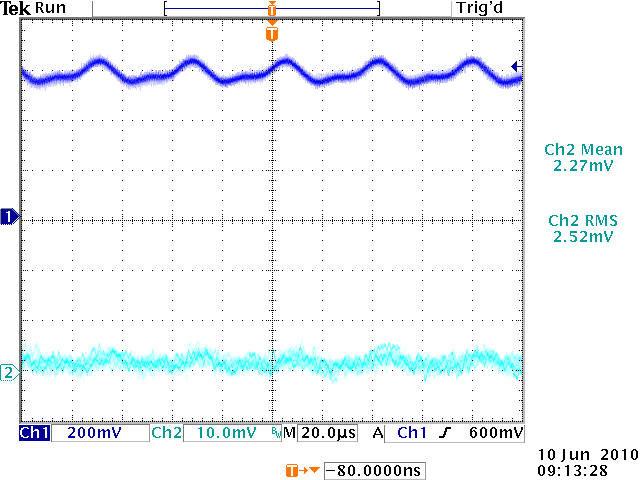
Documentation/Experimentation/load bank/10mV 7ma NPN.png
