k3iyer/arduino-dac/Documentation/Experimentation/load bank/32mV ref 30mA current N-channel mosfet.png

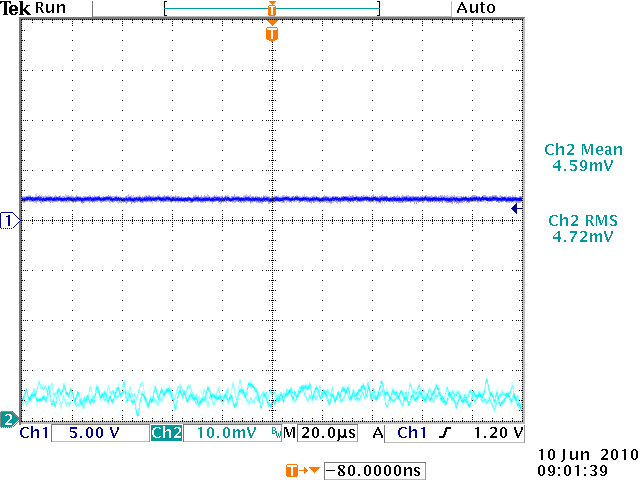
Documentation/Experimentation/load bank/32mV ref 30mA current N-channel mosfet.png
