k3iyer/arduino-dac/Documentation/Experimentation/load bank/50mV ref 58mA current N-channel mosfet.png

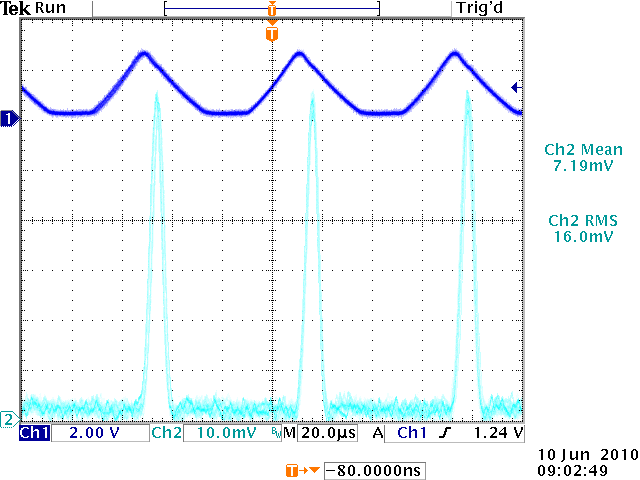
Documentation/Experimentation/load bank/50mV ref 58mA current N-channel mosfet.png
