k3iyer/arduino-dac/Documentation/Experimentation/load bank/100mV 104ma NPN.png

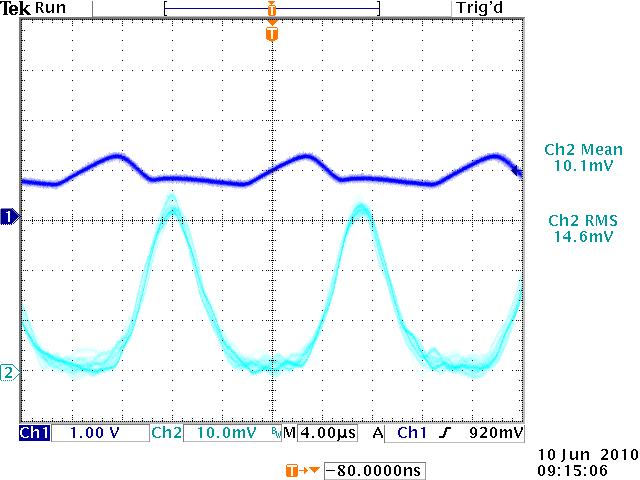
Documentation/Experimentation/load bank/100mV 104ma NPN.png
