k3iyer/arduino-dac/Documentation/Experimentation/load bank/500mV ref 817mA current N-channel mosfet.png

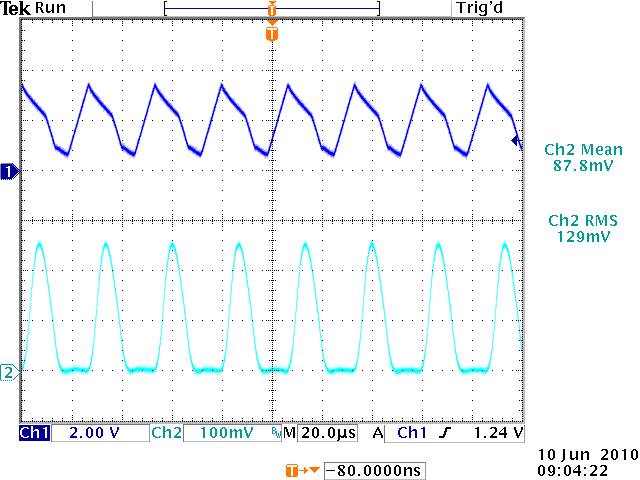
Documentation/Experimentation/load bank/500mV ref 817mA current N-channel mosfet.png
