k3iyer/arduino-dac/Documentation/Experimentation/load bank/1000mV 977ma NPN.png

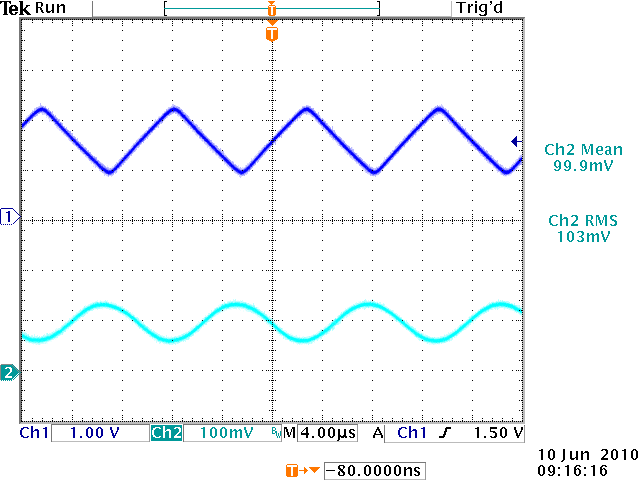
Documentation/Experimentation/load bank/1000mV 977ma NPN.png
