k3iyer/arduino-dac/Documentation/Experimentation/power demo board stability test/closed loop testing/1kHz_half period.png

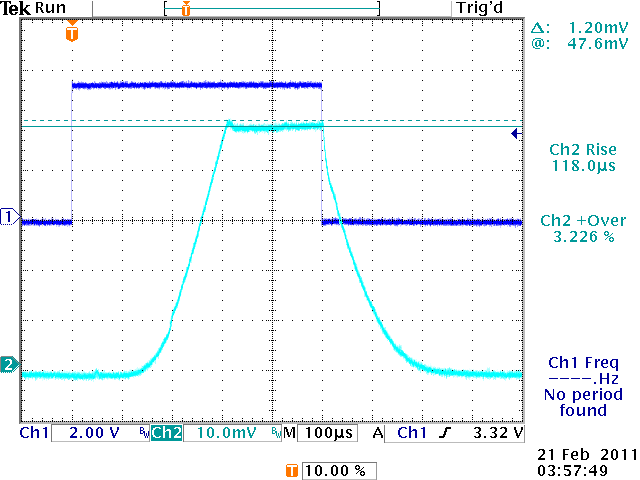
Documentation/Experimentation/power demo board stability test/closed loop testing/1kHz_half period.png
