k3iyer/arduino-dac/Documentation/Experimentation/power demo board stability test/MCP609-2.434V_Ref-CH2-100mV-Amp.png

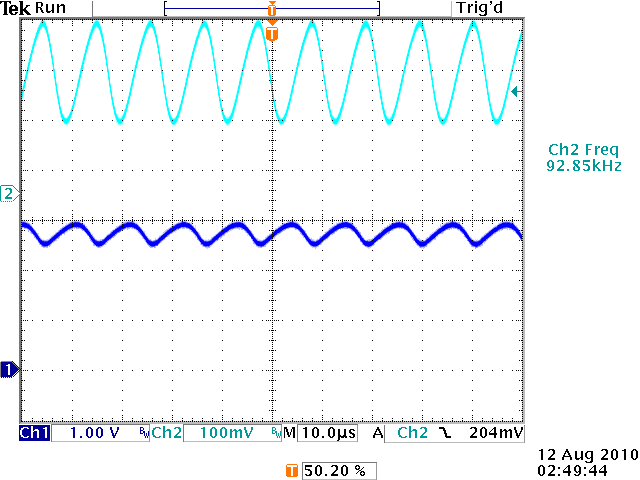
Documentation/Experimentation/power demo board stability test/MCP609-2.434V_Ref-CH2-100mV-Amp.png
