k3iyer/arduino-dac/Documentation/Experimentation/power demo board stability test/TLC2274CN-1.334V_Ref-CH2-100mV-Amp.png

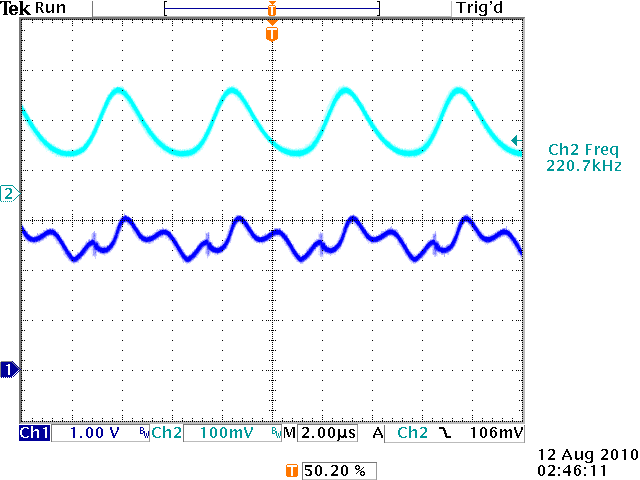
Documentation/Experimentation/power demo board stability test/TLC2274CN-1.334V_Ref-CH2-100mV-Amp.png
