k3iyer/arduino-dac/Documentation/Experimentation/profile outputs/profile 42 experimental dual channel, CH1 is charge, CH2 is discharge.png

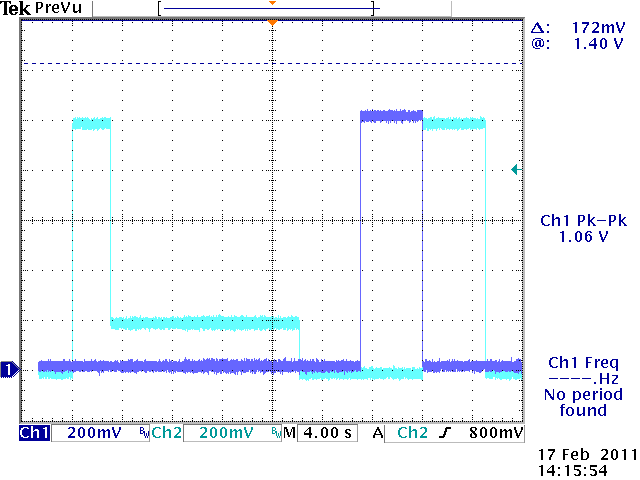
Documentation/Experimentation/profile outputs/profile 42 experimental dual channel, CH1 is charge, CH2 is discharge.png
