k3iyer/arduino-dac/Documentation/Experimentation/profile outputs/profile 64 experimental.png

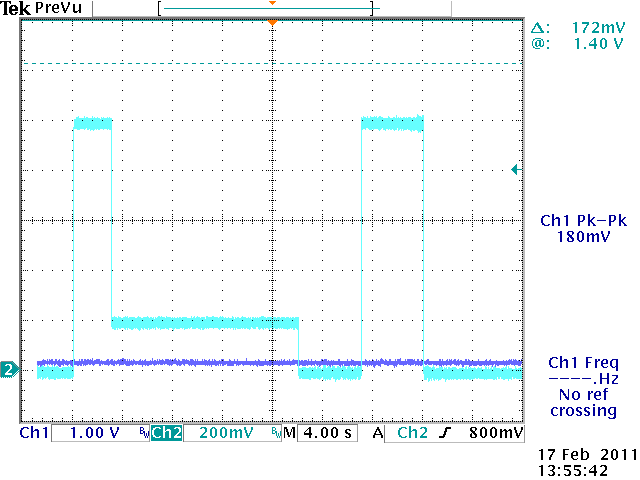
Documentation/Experimentation/profile outputs/profile 64 experimental.png
