k3iyer/arduino-dac/Documentation/Experimentation/profile outputs/using power stage - clamp on CH2 with 10mv per Amp, CH1 DAC charge ref.png

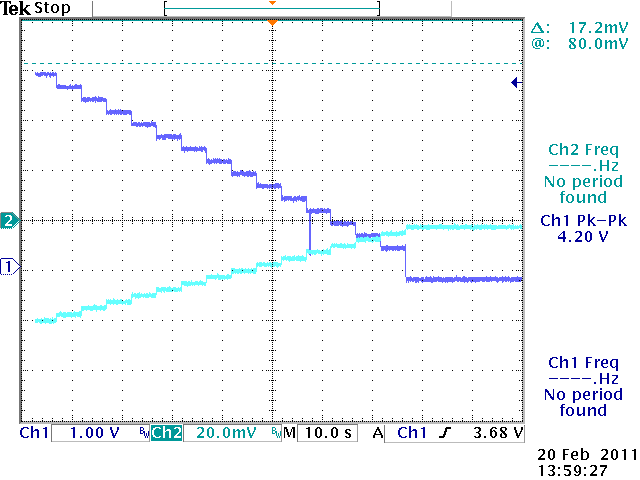
Documentation/Experimentation/profile outputs/using power stage - clamp on CH2 with 10mv per Amp, CH1 DAC charge ref.png
