k3iyer/arduino-dac/Documentation/Experimentation/with phase lead circuit.png

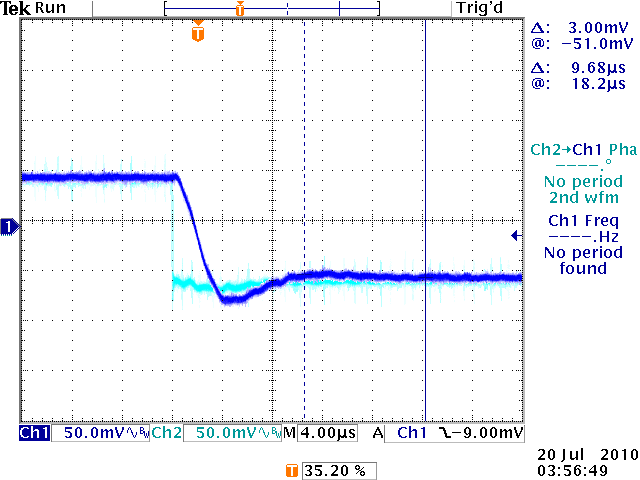
Documentation/Experimentation/with phase lead circuit.png
