k3iyer/arduino-dac/Device_Hardware/board layout/Battery Cycler Logic Board R0.1/logic board R0.1.pdf

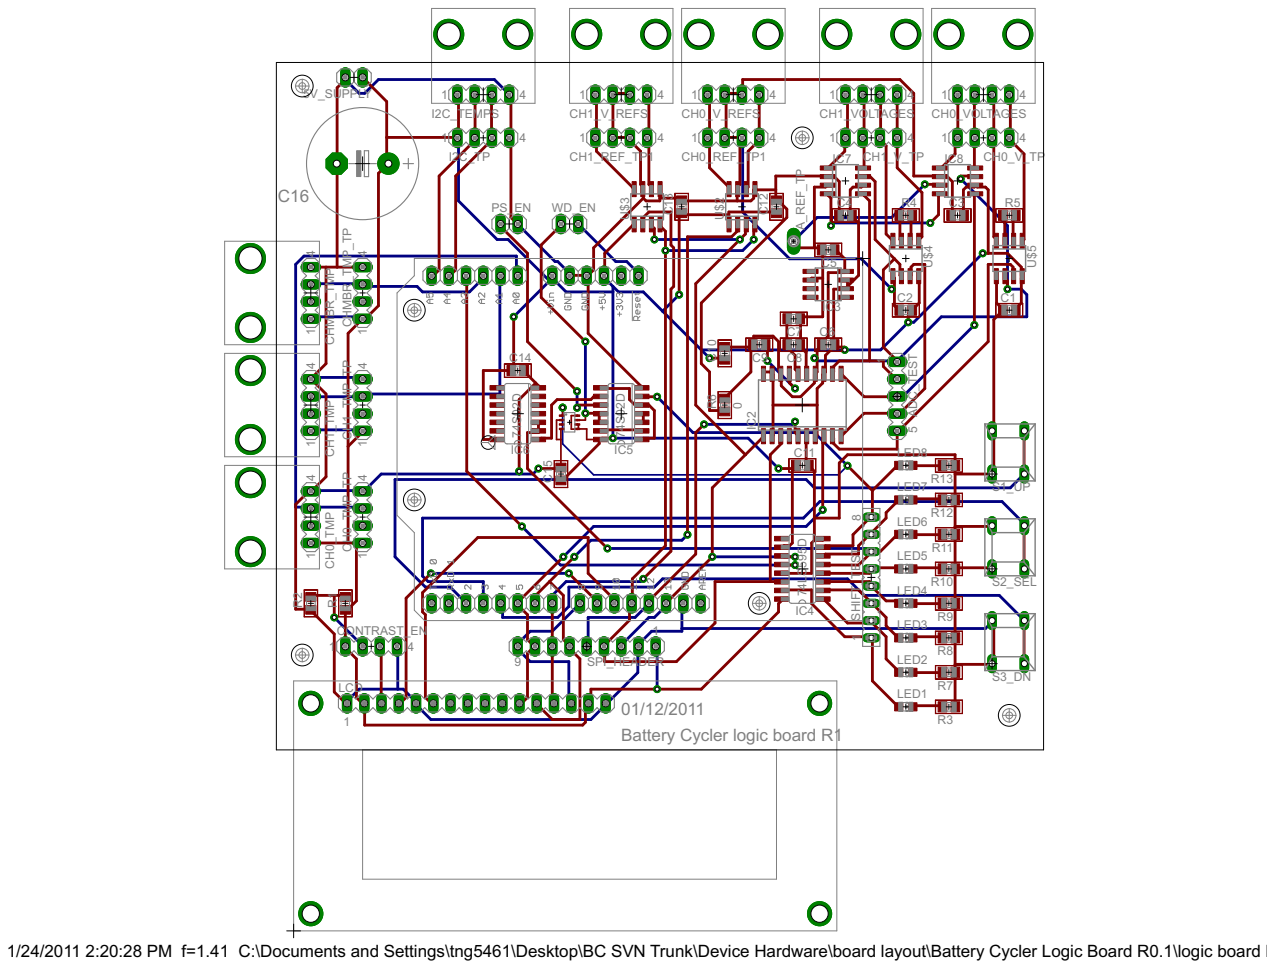
[picture p28: page 1]

Battery Cycler logic board R1

1/24/2011 2:20:28 PM f=1.41 C:\Documents and Settings\tng5461\Desktop\BC SVN Trunk\Device Hardware\board layout\Battery Cycler Logic Board R0.1\logic board R0.1.brd
