k3iyer/arduino-dac/Device_Hardware/schematics/hybrid battery-PSpiceFiles/SCHEMATIC1/sim/sim.cir

** Profile: "SCHEMATIC1-sim"  [ S:\BATTERY RESEARCH\schematics\hybrid battery-PSpiceFiles\SCHEMATIC1\sim.sim ] 

** Creating circuit file "sim.cir" 
** WARNING: THIS AUTOMATICALLY GENERATED FILE MAY BE OVERWRITTEN BY SUBSEQUENT SIMULATIONS

*Libraries: 
* Profile Libraries :
* Local Libraries :
* From [PSPICE NETLIST] section of C:\Software\Cadence\SPB_16.2\tools\PSpice\PSpice.ini file:
.lib "nom.lib" 

*Analysis directives: 
.AC DEC 10 1000 200000
.PROBE V(alias(*)) I(alias(*)) W(alias(*)) D(alias(*)) NOISE(alias(*)) 
.INC "..\SCHEMATIC1.net" 


.END
