k3iyer/arduino-dac/(list of files, drawings)

Other design files:
Device_Hardware/schematics/HYBRID BATTERY.DSN
Device_Hardware/schematics/hybrid battery.opj
Device_Hardware/schematics/LOADBANK_CHARGER.DSN
Device_Hardware/schematics/loadbank_charger.opj
Device_Hardware/schematics/NON_DIFF_SIM.DSN
Device_Hardware/schematics/non_diff_sim.opj
