k3iyer/arduino-dac/(commit log)

2010-12-30 see previous
    [10-umax-breakout.brd, 10-umax-breakout.sch, BOM DLC board for ted.xlsx, BOM DLC board proto.xlsx, BOM DLC board(old).xls, BOM DLC board.xlsx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]
2010-12-31 I have added a serial reciever that supports the currently outlined serial protocol using a circular buffer however a few bugs remain. I am really wishing I was working in a full IDE right now I thin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
    [Device_Software.pde, TLC3544.pde, com.pde]
2011-01-03 added full serial communication support for broadcasting heartbeat information, ACK messaging, and receiving and processing requests as well as checksums. The manual has been updated to reflect the c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
2011-01-03 system variables that can be altered in the hardwares menu system are now stored in EEPROM so we wont loose them. Still need to find a way to write default values to these addresses when programming 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
    [Device_Software.pde, menu.pde]
2011-01-10 updated manual formatting fixed profile processing within device software added test mode to device software, not yet functional, need to find way to false trigger heartbeats in full without enabling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
    [Device_Software.pde, com.pde, output.pde]
2011-01-10 altered dir structure for layout and cleaned out unrelated designs
    [10-umax-breakout.brd, 10-umax-breakout.sch, DESIGN1.DSN, Design1.opj, ESD3_BreakOut_V1.brd, ESD3_BreakOut_V1.sch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]
2011-01-10 updated logic board layout, added test points and necessary headers to make it a good dev board that is also very close to what we want. The board supports all IC's that could be on either power or l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
    Also updated the manual per some comments in review today. Changed the heirichy for save data dirs. Working on changing term 'Test' to 'experiment'
    Added in the pin assignments file from google docs. May still need to miagrate more docs over.
    [Battery Cycler - Pin assignments.xls, logic board R0.1.sch]
2011-01-12 updated the development logic board, should be ready for design review and then the board house
    [logic board R0.1.brd, logic board R0.1.sch]
2011-01-12 added psw configuration docu
    [PSW vs channel table.xlsx]
2011-01-25 revised logic board for first spin with dev board
    [logic board R0.1.brd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]
2011-08-11 RM'ed old changes
    [BOM DLC board for ted.xlsx, BOM DLC board proto.xlsx, BOM DLC board(old).xls, BOM DLC board.xlsx, BOM Logic Board.xlsx, BOM battery tester - Initial order.xlsx, Battery Cycler - Pin assignments.xls, HYBRID BATTERY.DSN]
